drdpj/RGBtoHDMI-Open-Audio/README.md

<!--
SPDX-License-Identifier: CC-BY-SA-4.0
SPDX-FileCopyrightText: 2026 Daniel Jameson
-->

# RGBtoHDMI Open Audio
## This is Open Hardware!

This is an open hardware audio interface for the popular RGBtoHDMI device.
RGBtoHDMI allows the use of many old computer systems with a modern HDMI display. The currently developed fork can be found here:
https://github.com/IanSB/RGBtoHDMI

A recent addition to the system's functionality has been to allow the injection of analogue audio to the HDMI connection. The software to do this is all covered by the GPL, but the hardware necessary is only available through select vendors.
This is an open version of the hardware which can be produced independently. It does not have all of the functionality of the original hardware, but this means it is marginally simpler and cheaper to produce. As it's open, if you do want to adapt the design to incorporate the missing feature (single pin multiplexing), you're absolutely free to!

Details of how the hardware can be attached to the RGBtoHDMI, and its usage, can be found in the official RGBtoHDMI wiki here: https://github.com/IanSB/RGBtoHDMI/wiki/Audio

The half-rate jumper is present (make link JP1). The facility to use a single GPIO is not present in this version (this was to accomodate use with a machine that wished to use the OSD option for FlashFloppy).

To support audio, you must use the latest beta release of the RGBtoHDMI software from here: https://github.com/IanSB/RGBtoHDMI/releases

I've used REUSE - https://reuse.software/ - to help make the licensing of this project clear.

[A plain English summary of the license can be found here.](./SUMMARY.md)

## Details
The audio system is based around a Texas Instruments PCM1808 ADC IC (https://www.ti.com/lit/ds/symlink/pcm1808.pdf) with a 12.288MHz oscillator. It requires 5V and 3.3V supplies, both of which are taken from the Rasperry Pi GPIO. Three data pins are required - BCK (the bitclock), LRCK (left/right clock) and DOUT (the audio data). As the RGBtoHDMI software can cope with the LRCK and DOUT being multiplexed to one pin, the software is set up in such a way that it uses the edges of the BCK signal, rather than the high/low, to clock the data. Consequently the BCK rate must be halved before it reaches the Pi GPIO. This is achieved using a 74LVC1G80 flipflop. Other components provide relevant pullups, power cleaning, and audio filters as specified in the PCM1808 data sheet.  One jumper connection is available (JP1) - making this connection will have the sample rate of the PCM1808 (24KHz instead of 48KHz).

This is hand-solderable (you will need magnification of some description). The parts are reasonably spaced out - just take your time.  If you're ordering boards, make sure to order half thickness - 0.8mm!

### BOM
| Reference | Qty | Value | Mouser Part (e.g.) |
|---|-----|---|---|
| C1, C4 | 2 | 1uF | 963-EMK107BJ105MAHT |
| C2, C3 | 2 | 10nF | 80-C0603C103M5R3121 |
| C5, C7, C10 | 3 | 10uF | 187-CL10A106MA8NRNC |
| C6, C8, C9 | 4 | 0.1uF | 791-0603B104K160CT |
| R1, R5 | 2 | 4K7 | 594-MCT0603MD4701DP5 |
| R2, R3 | 2 | 470R | 71-CRCW0603J-470-E3 |
| R4, R6, R7 | 3 | 560R | 652-CR0603-JW-561ELF |
| U1 | 1 | PCM1808PWR | 595-PCM1808PWR |
| U2 | 1 | 74LVC1G80  | 595-74LVC1G80DBVRG4 |
| Y1 | 1 | 12.288MHz  | 346-3225Z12.2880C15X |

### Front (prototype)


### Back
