drdpj/RGBtoHDMI-Open-Audio/(commit log)

2026-03-27 Enhance README with audio system details and images
    Added detailed description of the audio system and images of the prototype.
2026-03-27 Add new image for front prototype in README
    Added a new image to the README for better visualization.
2026-03-27 Update README with additional notes and BOM
    Added a note about schematics and PCB layout, included hand-soldering instructions, and added a BOM table.
2026-03-29 Uploading design files
    First commit of design files + license
    [rgbtohdmi-audio-CuBottom.gbr, rgbtohdmi-audio-CuTop.gbr, rgbtohdmi-audio-EdgeCuts.gbr, rgbtohdmi-audio-MaskBottom.gbr, rgbtohdmi-audio-MaskTop.gbr, rgbtohdmi-audio-NPTH.drl, rgbtohdmi-audio-PTH.drl, rgbtohdmi-audio-SilkBottom.gbr]
2026-04-03 Update README.md
    Added in the board thickness to order.
